ilkercakir/IOBoardV0/README.md

# IOBoardV0
IOT Control Board Console Application
