ilkercakir/IOBoardV0/C/images/controller.png

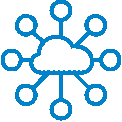
C/images/controller.png
