ilkercakir/IOBoardV0/PCB/IOBoardV0/Actuator_Relay.kicad_pcb

## KiCad design PCB/IOBoardV0/Actuator_Relay.kicad_pcb (2020-07-11)

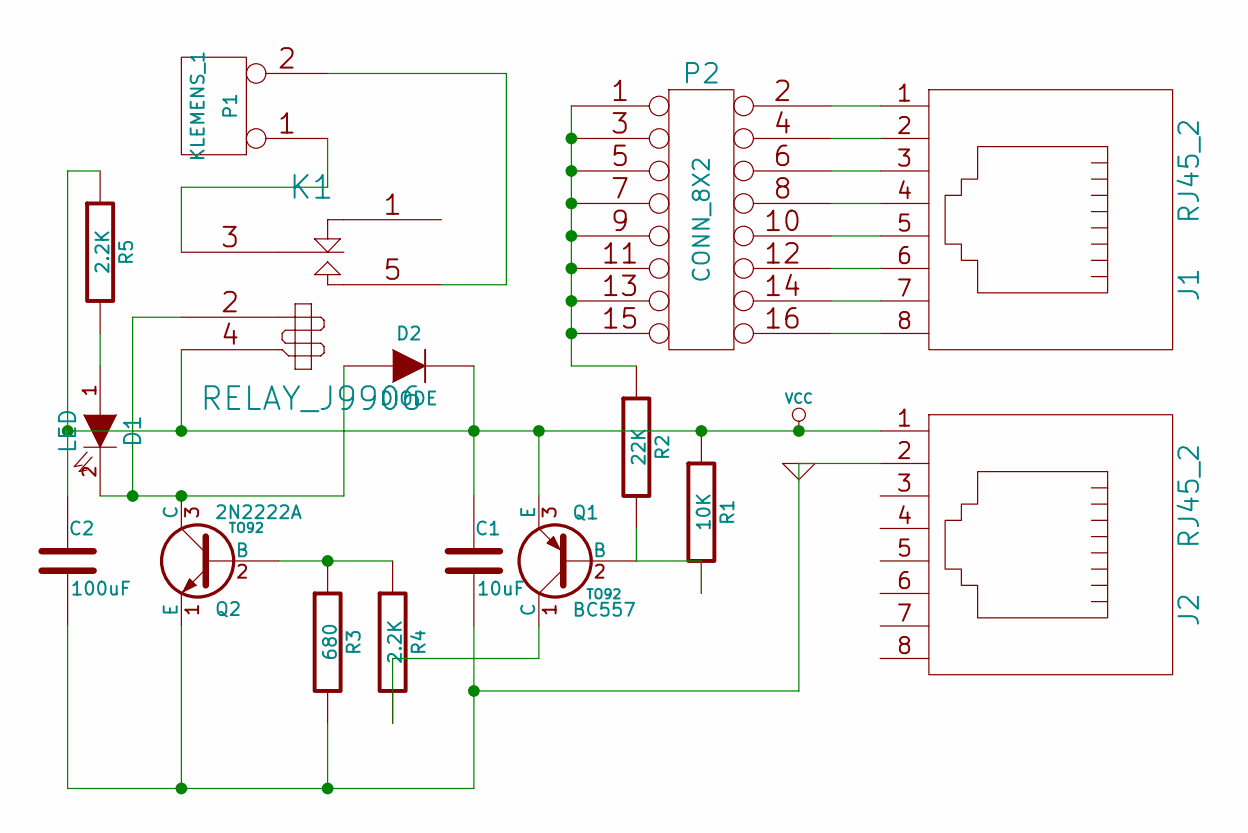
[picture p2: schematic Actuator_Relay.sch, noname.sch]

Parts:
C1: 10uF
C2: 100uF
D1: LED
D2: DIODE
J1, J2: RJ45_2
K1: RELAY_J9906
P1: KLEMENS_1
P2: CONN_8X2
Q1: BC557; TO92
Q2: 2N2222A; TO92
R1: 10K
R2: 22K
R3: 680
R4, R5: 2.2K

Connections:
GND: C1.2, C2.2, J2.2, Q2.1 (E), R3.2
unnamed: Q1.1 (C), R4.2
unnamed: Q1.2 (B), R1.2, R2.2
unnamed: Q2.2 (B), R3.1, R4.1
unnamed: D1.1 (A), R5.2
unnamed: K1.3 (C1), P1.1
unnamed: K1.5 (T1), P1.2 (PM)
unnamed: J1.8, P2.16
unnamed: J1.7, P2.14
unnamed: J1.6, P2.12
unnamed: J1.5, P2.10
unnamed: J1.4, P2.8
unnamed: J1.3, P2.6
unnamed: J1.2, P2.4
unnamed: J1.1, P2.2
unnamed: D1.2 (K), D2.1 (A), K1.2 (COIL1), Q2.3 (C)
unnamed: P2.1, P2.3, P2.5, P2.7, P2.9, P2.11, P2.13, P2.15, R2.1
VCC: C1.1, C2.1, D2.2 (K), J2.1, K1.4 (COIL2), Q1.3 (E), R1.1, R5.1

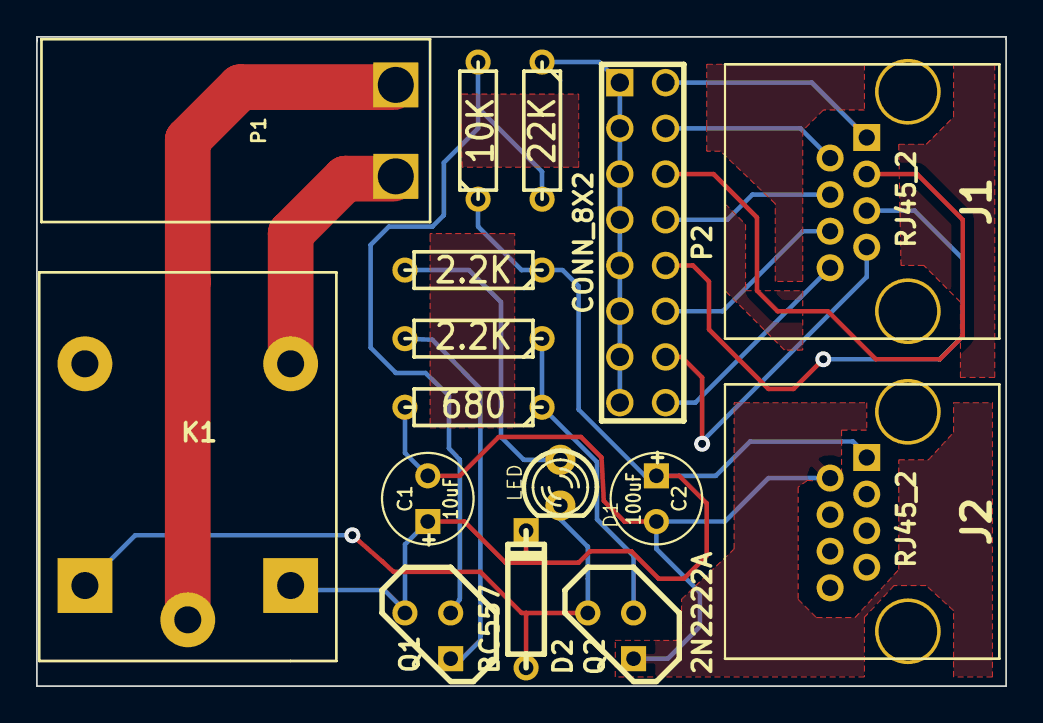
[picture p3: board Actuator_Relay.kicad_pcb from above]

Board: 2 copper layers, 53.8 x 36.1 mm, 16 parts (0 on the bottom side), 18 nets.
