ilkercakir/IOBoardV0/PCB/IOBoardV0/WaterLevel.kicad_pcb

## KiCad design PCB/IOBoardV0/WaterLevel.kicad_pcb (2020-07-11)

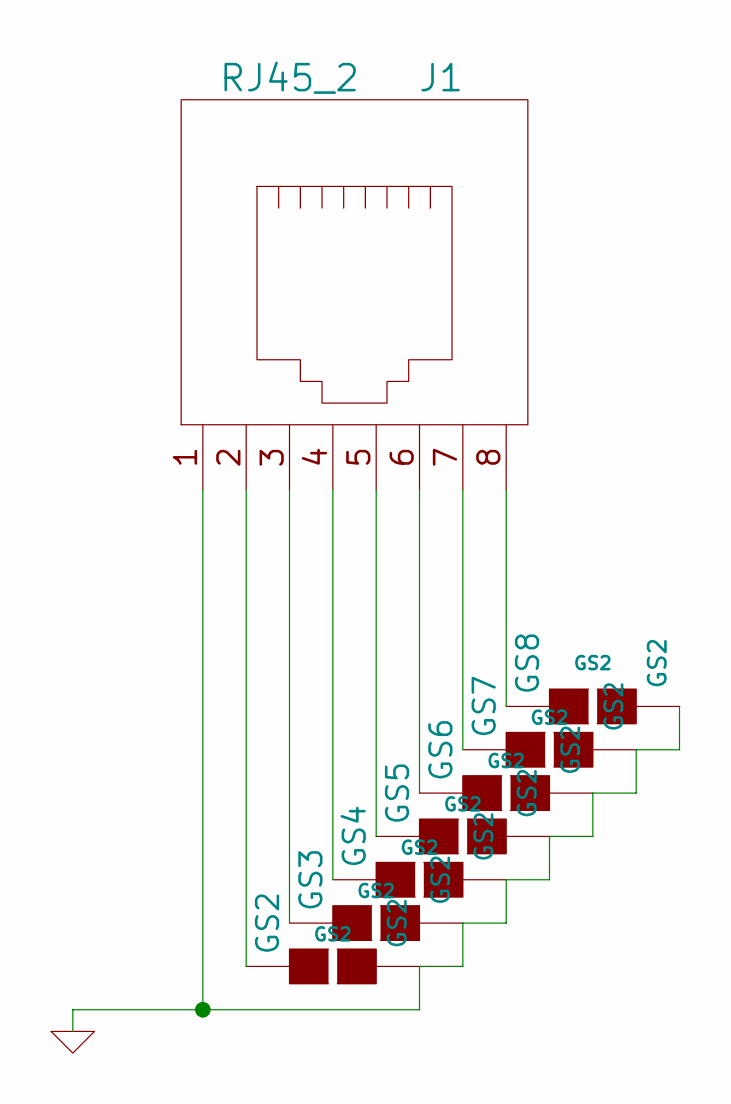
[picture p4: schematic WaterLevel.sch]

Parts:
GS2, GS3, GS4, GS5, GS6, GS7, GS8: GS2
J1: RJ45_2

Connections:
GND: GS2.2 (G2), GS3.2 (G2), GS4.2 (G2), GS5.2 (G2), GS6.2 (G2), GS7.2 (G2), GS8.2 (G2), J1.1
unnamed: GS5.1 (G1), J1.5
unnamed: GS2.1 (G1), J1.2
unnamed: GS3.1 (G1), J1.3
unnamed: GS4.1 (G1), J1.4
unnamed: GS6.1 (G1), J1.6
unnamed: GS7.1 (G1), J1.7
unnamed: GS8.1 (G1), J1.8

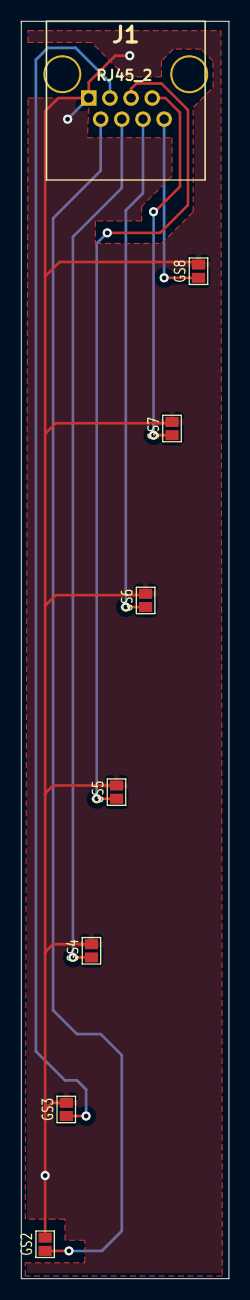
[picture p5: board WaterLevel.kicad_pcb from above]

Board: 2 copper layers, 19.9 x 120.8 mm, 8 parts (0 on the bottom side), 8 nets.
