ilkercakir/IOBoardV0/PCB/IOBoardV0/IOBoardV0.kicad_pcb

## KiCad design PCB/IOBoardV0/IOBoardV0.kicad_pcb (2020-07-11)

Schematic: IOBoardV0.sch

Parts:
C1, C2, C3, C4: 10uF
D1: DIODE
D2, D3: LED
J2, J3, J4, J5, J6, J7, J8, J9: RJ45_2
P1: RASPBERRY_HAT
R1, R2, R3, R4: 10K
R5: 2.2K
R6: 3.3K
U1: 74LS04
U2: 74LS138
U3: 74LS164
U4: 74LS373
U5: 74LS74
U6: 74LS165

Connections:
/A0: J2.1, J3.1, J4.1, J5.1, U4.2 (O0)
/A1: J2.2, J3.2, J4.2, J5.2, U4.5 (O1)
/A2: J2.3, J3.3, J4.3, J5.3, U4.6 (O2)
/A3: J2.4, J3.4, J4.4, J5.4, U4.9 (O3)
/A4: J2.5, J3.5, J4.5, J5.5, U4.12 (O4)
/A5: J2.6, J3.6, J4.6, J5.6, U4.15 (O5)
/A6: J2.7, J3.7, J4.7, J5.7, U4.16 (O6)
/A7: J2.8, J3.8, J4.8, J5.8, U4.19 (O7)
/S0: J6.1, J7.1, J8.1, J9.1, U6.11 (P0)
/S1: J6.2, J7.2, J8.2, J9.2, U6.12 (P1)
/S2: J6.3, J7.3, J8.3, J9.3, U6.13 (P2)
/S3: J6.4, J7.4, J8.4, J9.4, U6.14 (P3)
/S4: J6.5, J7.5, J8.5, J9.5, U6.3 (P4)
/S5: J6.6, J7.6, J8.6, J9.6, U6.4 (P5)
/S6: J6.7, J7.7, J8.7, J9.7, U6.5 (P6)
/S7: J6.8, J7.8, J8.8, J9.8, U6.6 (P7)
GND: C1.2, C2.2, C3.2, C4.2, P1.6, R3.2, R6.2, U1.7 (GND), U2.4 (E1), U2.5 (E2), U2.8 (GND), U3.7 (GND), U4.10 (GND), U5.7 (GND), U6.8 (GND), U6.15 (CE)
unnamed: U5.6 (~Q), U6.10 (Ds)
unnamed: P1.18, R5.2, R6.1
unnamed: D3.2 (K), U5.9 (Q)
unnamed: U2.13 (O2), U6.1 (Pl)
unnamed: U2.12 (O3), U6.2 (CP)
unnamed: R5.1, U6.7 (~Q7)
unnamed: U2.10 (O5), U5.11 (Cp)
unnamed: U2.11 (O4), U5.3 (Cp)
unnamed: U1.11, U2.14 (O1)
unnamed: U2.15 (O0), U3.8 (CLK)
unnamed: U3.5 (Q2), U4.7 (D2)
unnamed: U3.10 (Q4), U4.13 (D4)
unnamed: U3.11 (Q5), U4.14 (D5)
unnamed: U3.3 (Q0), U4.3 (D0)
unnamed: U3.4 (Q1), U4.4 (D1)
unnamed: P1.15, R2.2, U1.5
unnamed: U1.6, U2.6 (E3)
unnamed: P1.11, U2.1 (A0)
unnamed: U1.2, U1.3
unnamed: P1.13, U2.3 (A2)
unnamed: P1.12, U2.2 (A1)
unnamed: U3.13 (Q7), U4.18 (D7)
unnamed: U3.12 (Q6), U4.17 (D6)
unnamed: U3.6 (Q3), U4.8 (D3)
unnamed: P1.16, U1.9
unnamed: U4.1 (OE), U5.5 (Q)
unnamed: U1.10, U4.11 (LE)
unnamed: U1.8, U3.1 (A), U5.2 (D), U5.12 (D)
unnamed: D2.2 (K), R3.1
unnamed: C1.1, D1.1 (A), R1.2, U1.1
unnamed: D3.1 (A), R4.2
unnamed: U1.4, U5.4 (Sd), U5.10 (Sd)

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
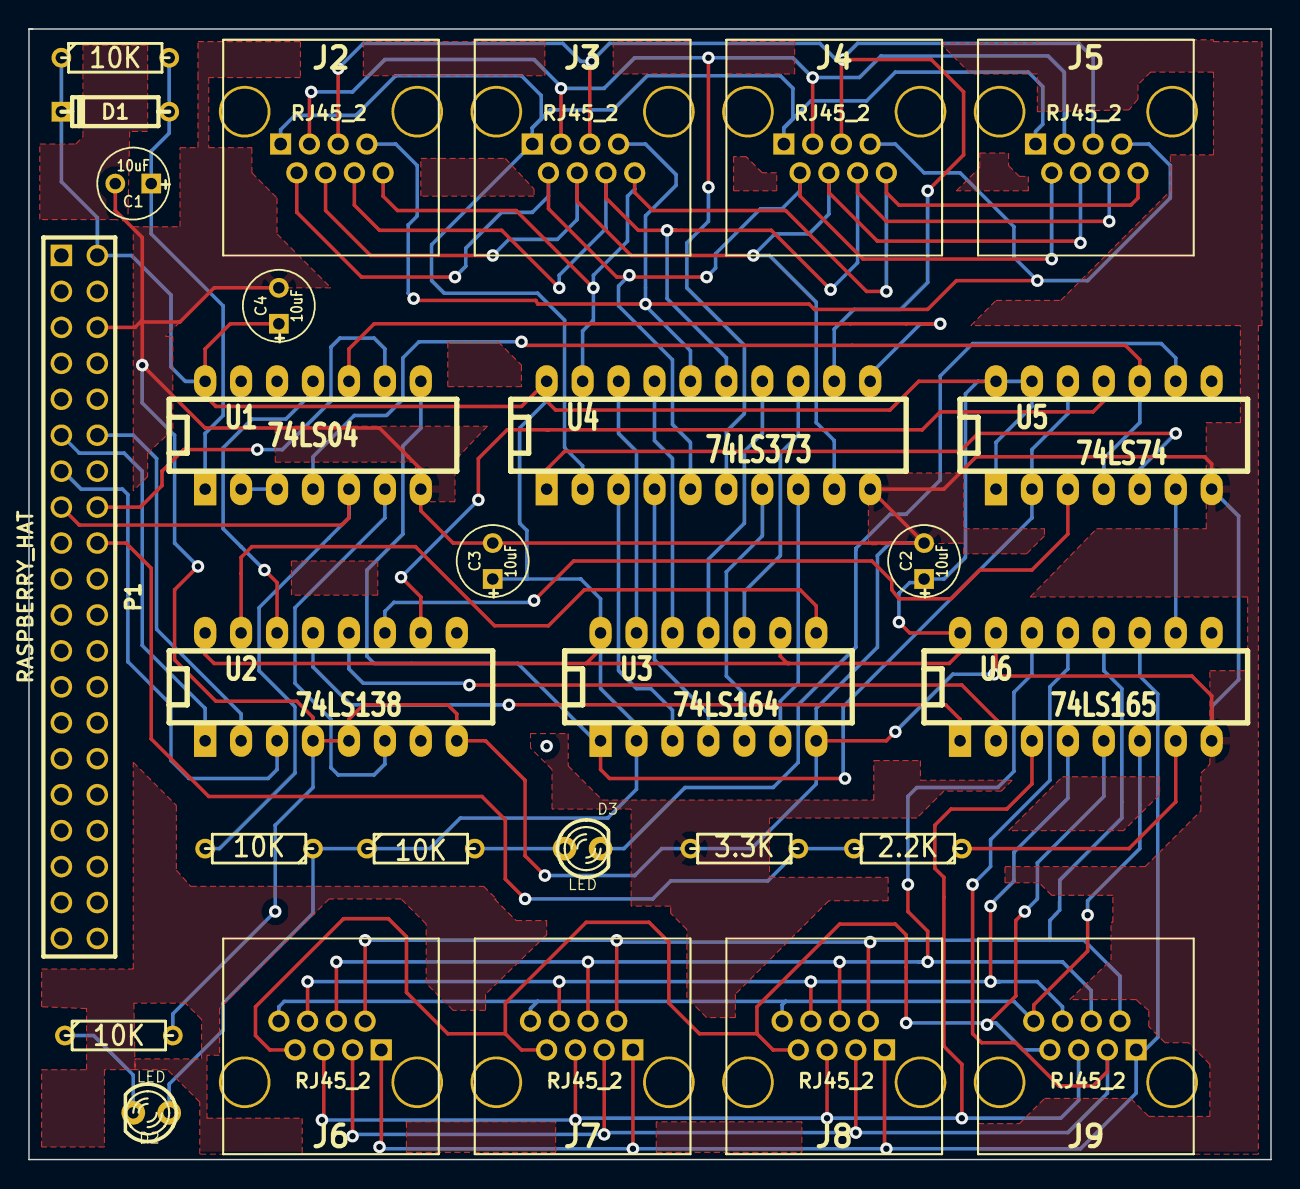
[picture p6: board IOBoardV0.kicad_pcb from above]

Board: 2 copper layers, 87.8 x 79.9 mm, 28 parts (0 on the bottom side), 50 nets.
