ilkercakir/IOBoardV0/PCB/IOBoardV0/Sensor_Level.kicad_pcb

## KiCad design PCB/IOBoardV0/Sensor_Level.kicad_pcb (2020-04-25)

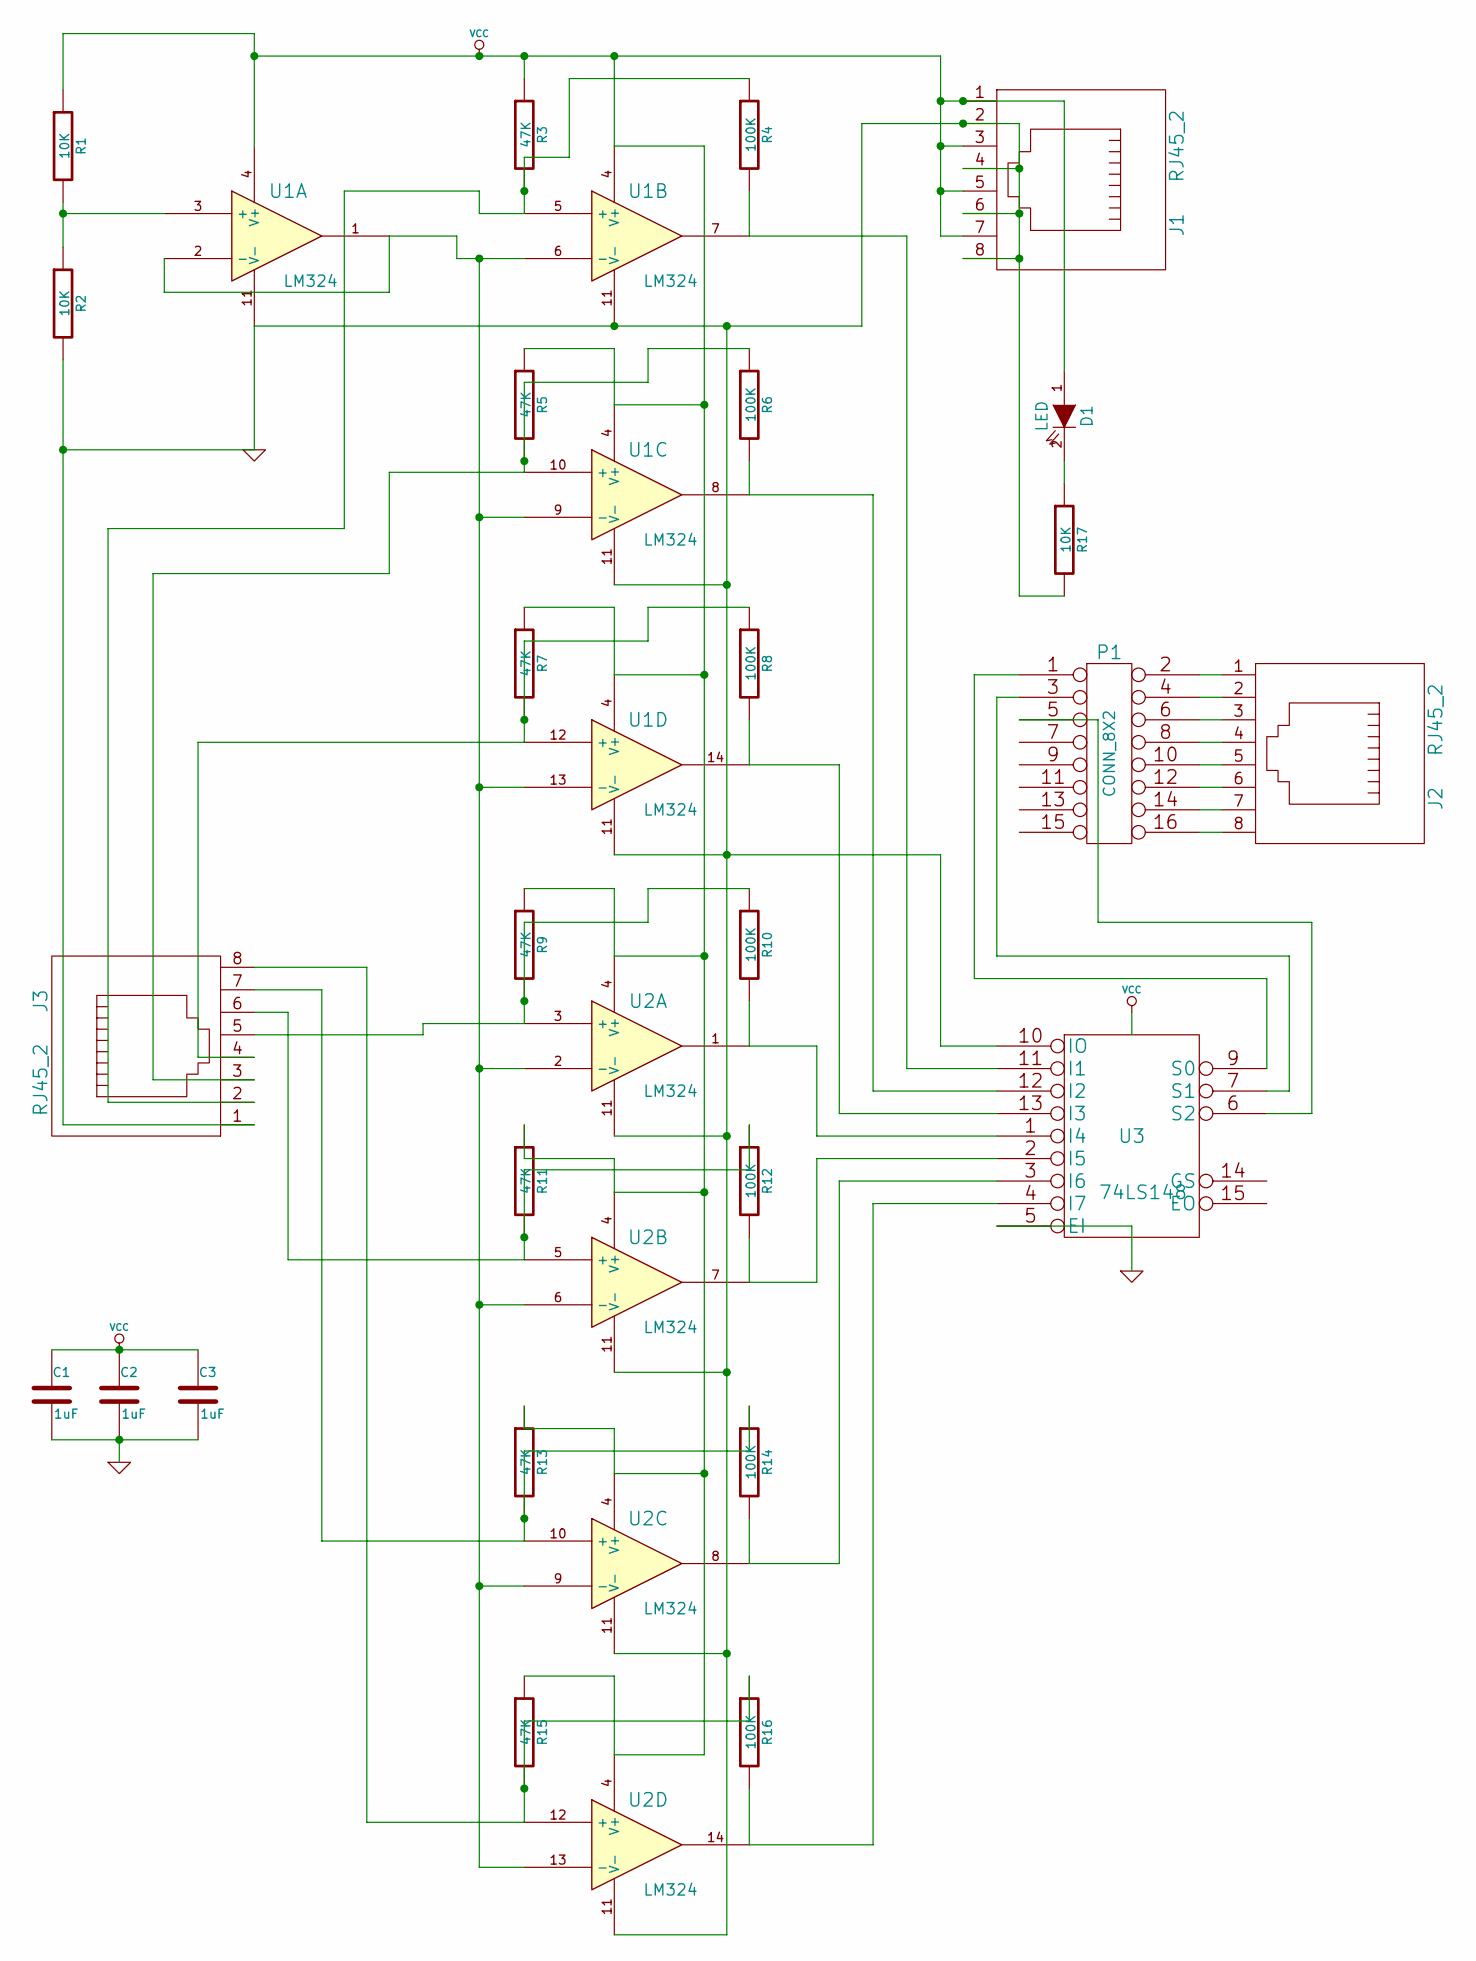
[picture p7: schematic Sensor_Level.sch]

Parts:
C1, C2, C3: 1uF
D1: LED
J1, J2, J3: RJ45_2
P1: CONN_8X2
R1, R2, R17: 10K
R3, R5, R7, R9, R11, R13, R15: 47K
R4, R6, R8, R10, R12, R14, R16: 100K
U1, U2: LM324
U3: 74LS148

Connections:
GND: C1.2, C2.2, C3.2, J1.2, J1.4, J1.6, J1.8, J3.1, R2.2, R17.2, U1.11 (V-), U2.11 (V-), U3.5 (EI), U3.8 (GND), U3.10 (IO)
unnamed: R12.2, U2.7, U3.2 (I5)
unnamed: R16.2, U2.14, U3.4 (I7)
unnamed: R14.2, U2.8, U3.3 (I6)
unnamed: R10.2, U2.1, U3.1 (I4)
unnamed: R8.2, U1.14, U3.13 (I3)
unnamed: P1.5, U3.6 (S2)
unnamed: D1.2 (K), R17.1
unnamed: P1.1, U3.9 (S0)
unnamed: J2.6, P1.12
unnamed: J2.5, P1.10
unnamed: J2.4, P1.8
unnamed: J2.3, P1.6
unnamed: J2.2, P1.4
unnamed: J2.1, P1.2
unnamed: J2.8, P1.16
unnamed: P1.3, U3.7 (S1)
unnamed: J2.7, P1.14
unnamed: J3.7, R13.2, R14.1, U2.10 (+)
unnamed: J3.6, R11.2, R12.1, U2.5 (+)
unnamed: J3.5, R9.2, R10.1, U2.3 (+)
unnamed: J3.4, R7.2, R8.1, U1.12 (+)
unnamed: J3.3, R5.2, R6.1, U1.10 (+)
unnamed: R6.2, U1.8, U3.12 (I2)
unnamed: R4.2, U1.7, U3.11 (I1)
unnamed: J3.8, R15.2, R16.1, U2.12 (+)
unnamed: R1.2, R2.1, U1.3 (+)
unnamed: J3.2, R3.2, R4.1, U1.5 (+)
unnamed: U1.1, U1.2 (-), U1.6 (-), U1.9 (-), U1.13 (-), U2.2 (-), U2.6 (-), U2.9 (-), U2.13 (-)
VCC: C1.1, C2.1, C3.1, D1.1 (A), J1.1, J1.3, J1.5, J1.7, R1.1, R3.1, R5.1, R7.1, R9.1, R11.1, R13.1, R15.1, U1.4 (V+), U2.4 (V+), U3.16 (VCC)

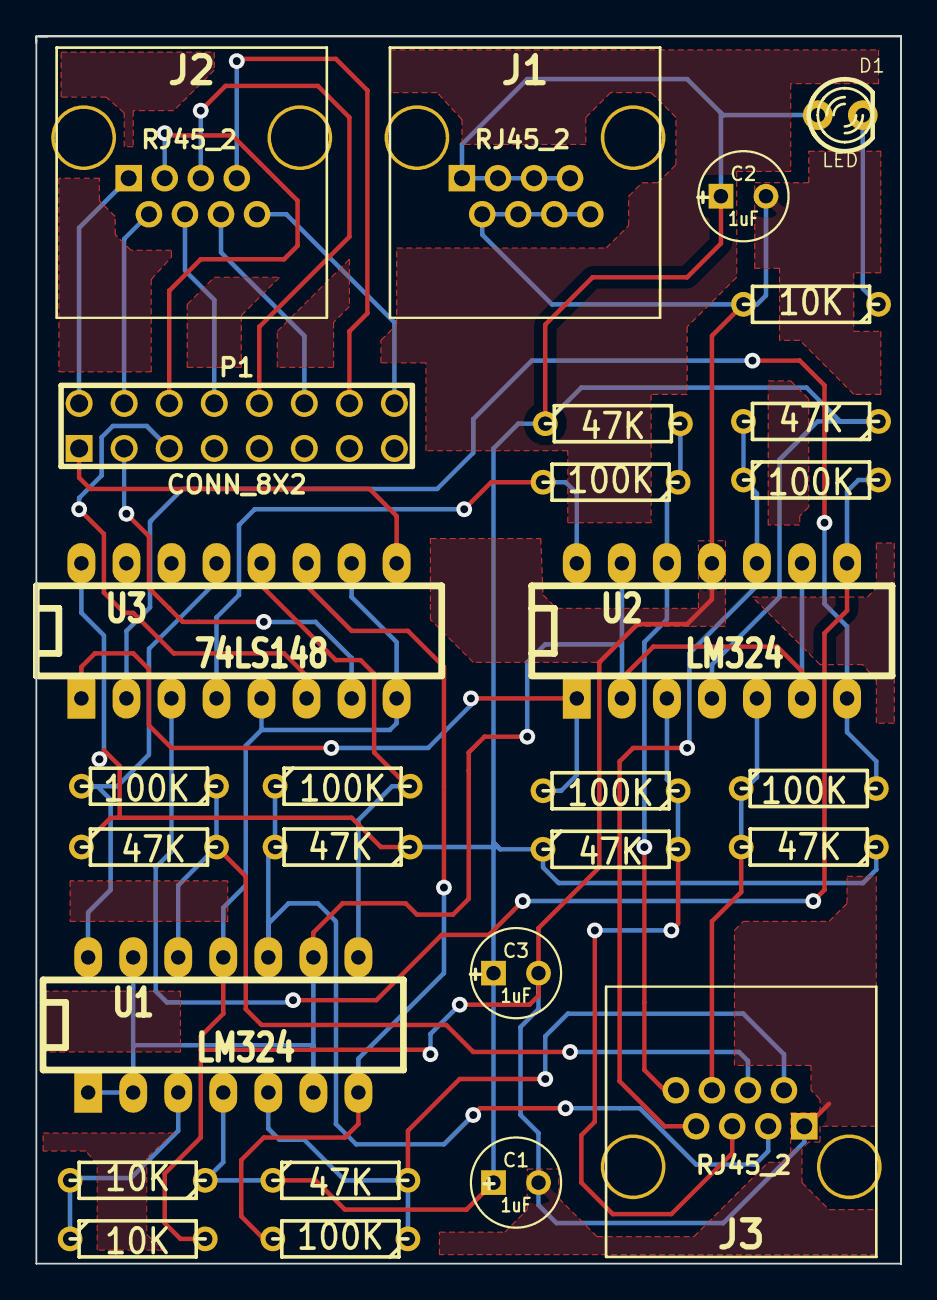
[picture p8: board Sensor_Level.kicad_pcb from above]

Board: 2 copper layers, 48.8 x 69.2 mm, 28 parts (0 on the bottom side), 30 nets.
