ilkercakir/IOBoardV0/PCB/IOBoardV0/Power.kicad_pcb

## KiCad design PCB/IOBoardV0/Power.kicad_pcb (2020-04-25)

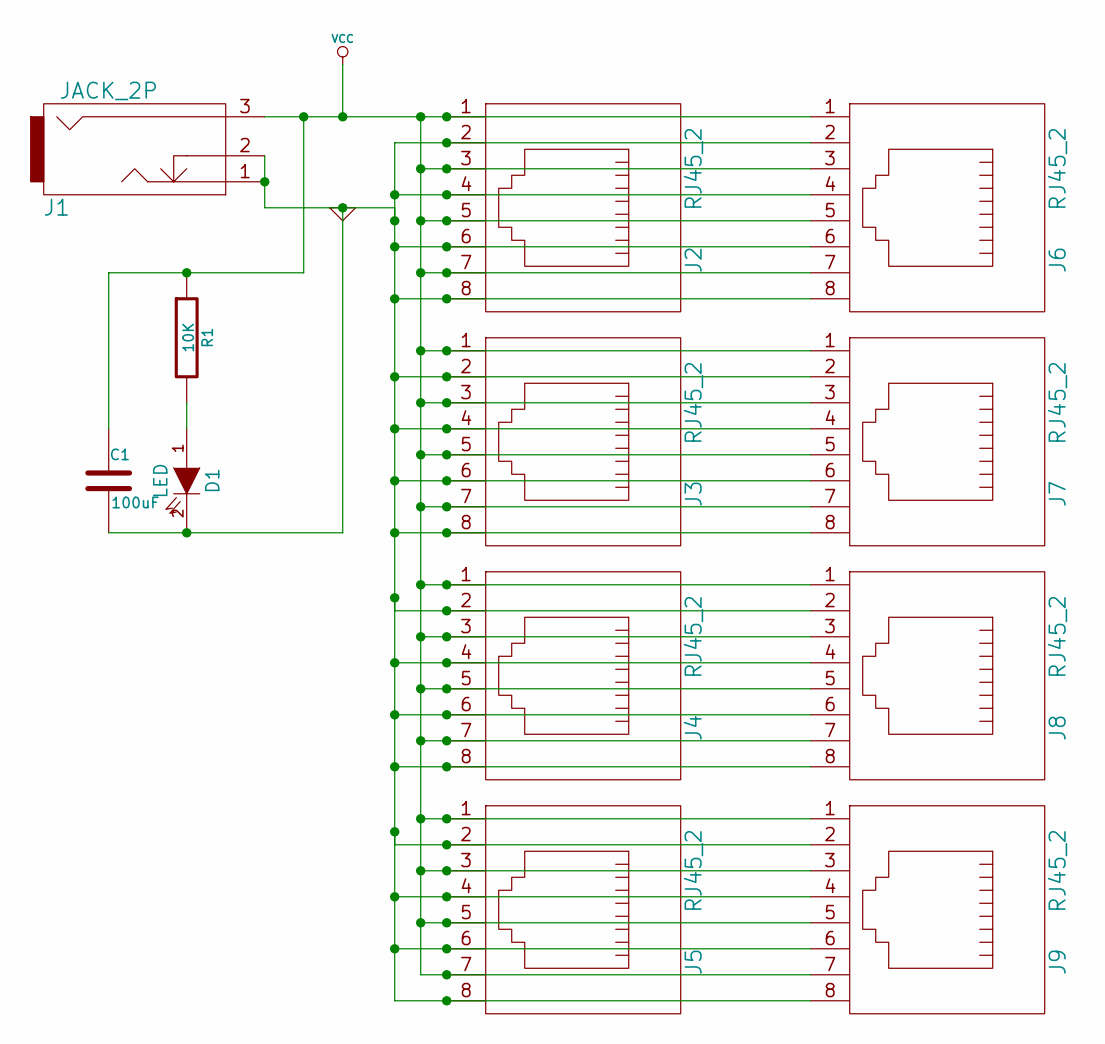
[picture p9: schematic Power.sch, noname.sch]

Parts:
C1: 100uF
D1: LED
J1: JACK_2P
J2, J3, J4, J5, J6, J7, J8, J9: RJ45_2
R1: 10K

Connections:
GND: C1.2, D1.2 (K), J1.1, J1.2, J2.2, J2.4, J2.6, J2.8, J3.2, J3.4, J3.6, J3.8, J4.2, J4.4, J4.6, J4.8, J5.2, J5.4, J5.6, J5.8, J6.2, J6.4, J6.6, J6.8, J7.2, J7.4, J7.6, J7.8, J8.2, J8.4, J8.6, J8.8, J9.2, J9.4, J9.6, J9.8
unnamed: D1.1 (A), R1.2
VCC: C1.1, J1.3, J2.1, J2.3, J2.5, J2.7, J3.1, J3.3, J3.5, J3.7, J4.1, J4.3, J4.5, J4.7, J5.1, J5.3, J5.5, J5.7, J6.1, J6.3, J6.5, J6.7, J7.1, J7.3, J7.5, J7.7, J8.1, J8.3, J8.5, J8.7, J9.1, J9.3, J9.5, J9.7, R1.1

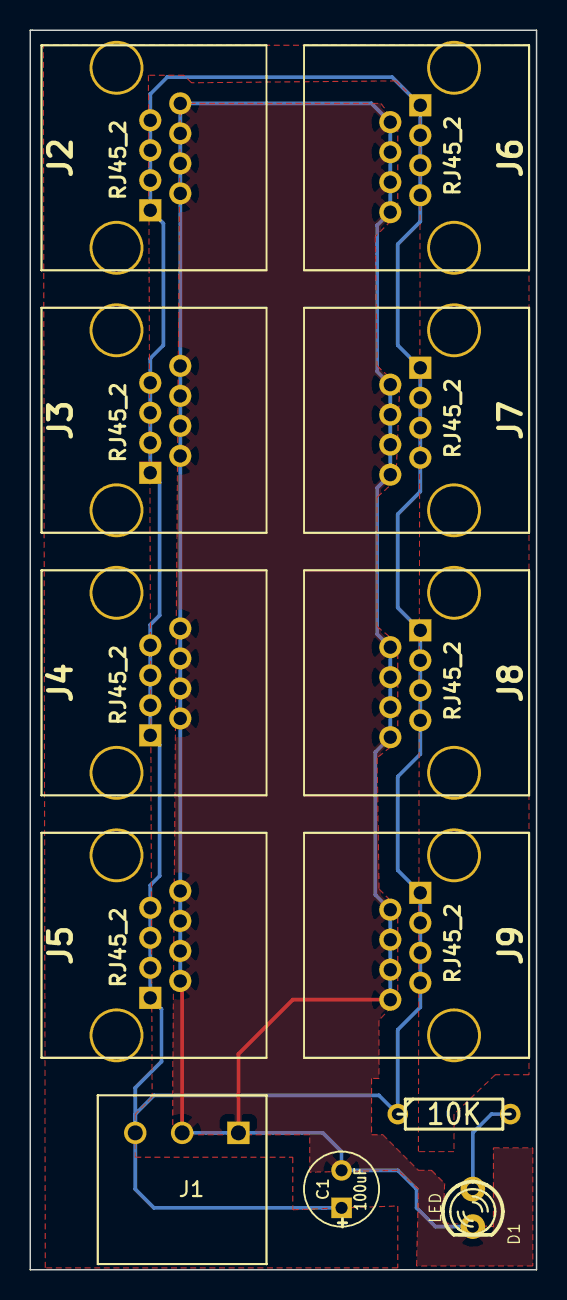
[picture p10: board Power.kicad_pcb from above]

Board: 2 copper layers, 34.3 x 83.9 mm, 12 parts (0 on the bottom side), 3 nets.
